joshjessup/Group49/README.md

# Group49
2019/20 UBC ECE Capstone - Group 49
