joshjessup/Group49/Bill of materials/Non-MFG BOM.xlsx

Part | Description | Cost | Link | Comment
Battery 1 | Li, 3.7V, 1200mAh, 62x34x5mm | 9.95USD | https://www.adafruit.com/product/258 | ~32 hr battery life according to our estimates - we have this battery
Battery 2 | Li, 3.7V, 400mAh, 35.5x16.6x7.6mm | 6.95USD | https://www.adafruit.com/product/3898 | 32*0.33 = 10 hr battery life - optimal for reduced enclosure size
Battery 3 | Li, 3.7V, 2000mAh, 60x36x7mm | 12.5USD | https://www.adafruit.com/product/2011 | 32 * 1.66 = 53 hr battery life
Electrodes | Dry and/or wet | N/A | N/A | Provided by SimPL
Enclosure | 3D Printed | N/A | N/A | Cost dependant on printing, designed for small battery (Battery 2)
PicKit 4 | for programming MCU | 75.80CAD | https://www.digikey.ca/en/products/detail/microchip-technology/PG164140/8536593
FTDI | for serial programming | 32.33CAD | https://www.digikey.ca/en/products/detail/ftdi-future-technology-devices-international-ltd/TTL-232RG-VIP-WE/2441358
MicroSD |  | Various |  | Any MicroSD
