joshjessup/Group49/Bill of materials/Bill of Materials-EEG_circuit.xlsx

Case/Package | Category | Description | Footprint | LibRef | Manufacturer 1 | Manufacturer Lifecycle 1 | Manufacturer Part Number 1 | Quantity | Supplier 1 | Supplier Currency 1 | Supplier Order Qty 1 | Supplier Part Number 1 | Supplier Stock 1 | Supplier Subtotal 1 | Supplier Subtotal per Board 1 | Supplier Unit Price 1 | Designator | Value
 |  | 0402 Cap 18pF | 0402resistor | 18pF_Cap | KEMET (https://octopart-clicks.com/click/altium?sku=399-19371-6-ND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) | Unknown | C0402C180K5RAC7867 (https://octopart-clicks.com/click/altium?sku=399-19371-6-ND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) | 2 | Digi-Key | USD | 2 | 399-19371-6-ND (https://octopart-clicks.com/click/altium?sku=399-19371-6-ND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) | 3539 | 0.42 | 0.42 | 0.21 | C20, C21 | 18pF
 |  | CONN HEADER SMD 2POS 2MM | Battery_Conn | B2B-PH-SM4-TBT(LF)(SN) | JST (https://octopart-clicks.com/click/altium?sku=455-2872-6-ND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) | Volume Production | B2B-PH-SM4-TBT(LF)(SN) (https://octopart-clicks.com/click/altium?sku=455-2872-6-ND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) | 1 | Digi-Key |  | 1 | 455-2872-6-ND (https://octopart-clicks.com/click/altium?sku=455-2872-6-ND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) | 0 |  |  |  | J1
 |  | GLOBAL CONNECTOR TECHNOLOGY MEM2067-02-180-00-A MEMORY CARD CONNECTOR, 8 POSITION | SD_Conn | MEM2067-02-180-00-A | Global Connector Technology (https://octopart-clicks.com/click/altium?manufacturer=Global%20Connector%20Technology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) | Volume Production | MEM2067-02-180-00-A (https://octopart-clicks.com/click/altium?manufacturer=Global%20Connector%20Technology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) | 1 | Digi-Key |  | 1 | 2073-MEM2067-02-180-00-ACT-ND (https://octopart-clicks.com/click/altium?manufacturer=Global%20Connector%20Technology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) | 0 |  |  |  | J3
 |  | MINI SPDT SLIDE SWITCH 6.7 X 2.7 MM PINS 4-9 ARE MOUNTING | SW_SPDT | 450404015514 | Wurth Electronics (https://octopart-clicks.com/click/altium?sku=732-13665-6-ND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) | Unknown | 450404015514 (https://octopart-clicks.com/click/altium?sku=732-13665-6-ND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) | 1 | Digi-Key | USD | 1 | 732-13665-6-ND (https://octopart-clicks.com/click/altium?sku=732-13665-6-ND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) | 2490 | 0.75 | 0.75 | 0.75 | SW3
 |  | WURTH ELEKTRONIK 61300621121 Board-To-Board Connector, Vertical, WR-PHD Series, Through Hole, Header, 6 Contacts, 2.54 mm | 6pin_Header | 61300621121 | Wurth Electronics (https://octopart-clicks.com/click/altium?sku=732-5295-ND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) | Volume Production | 61300621121 (https://octopart-clicks.com/click/altium?sku=732-5295-ND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) | 1 | Digi-Key | USD | 1 | 732-5295-ND (https://octopart-clicks.com/click/altium?sku=732-5295-ND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) | 2352 | 0.54 | 0.54 | 0.54 | J4
 |  | WURTH ELEKTRONIK 61301211121 Board-To-Board Connector, Vertical, WR-PHD Series, Through Hole, Header, 12 Contacts, 2.54 mm | HDR1X12 | 61301211121 | Wurth Electronics (https://octopart-clicks.com/click/altium?sku=732-5323-ND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) | Volume Production | 61301211121 (https://octopart-clicks.com/click/altium?sku=732-5323-ND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) | 1 | Digi-Key | USD | 1 | 732-5323-ND (https://octopart-clicks.com/click/altium?sku=732-5323-ND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) | 266 | 0.54 | 0.54 | 0.54 | J2
0402 |  | 0402 Cap 0.1uF | 0402resistor | 0.1uF_Cap | Samsung (https://octopart-clicks.com/click/altium?sku=1276-1022-6-ND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) | Volume Production | CL05A104KP5NNNC (https://octopart-clicks.com/click/altium?sku=1276-1022-6-ND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) | 6 | Digi-Key | USD | 6 | 1276-1022-6-ND (https://octopart-clicks.com/click/altium?sku=1276-1022-6-ND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) | 11994234 | 0.6 | 0.6 | 0.1 | C2, C5, C7, C10, C12, C18 | 0.1uF
0402 |  | 0402 Cap 1uF | 0402resistor | 1uF_Cap | Murata (https://octopart-clicks.com/click/altium?sku=490-14577-6-ND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) | Volume Production | GRM153R61A105ME95D (https://octopart-clicks.com/click/altium?sku=490-14577-6-ND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) | 5 | Digi-Key | USD | 5 | 490-14577-6-ND (https://octopart-clicks.com/click/altium?sku=490-14577-6-ND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) | 42932 | 0.95 | 0.95 | 0.19 | C1, C4, C6, C15, C16 | 1uF
0402 |  | 0402 Cap 1.5nF | 0402resistor | 1.5nF_Cap | Samsung (https://octopart-clicks.com/click/altium?sku=1276-1521-6-ND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) | Volume Production | CL05B152KB5NNNC (https://octopart-clicks.com/click/altium?sku=1276-1521-6-ND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) | 1 | Digi-Key | USD | 1 | 1276-1521-6-ND (https://octopart-clicks.com/click/altium?sku=1276-1521-6-ND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) | 647850 | 0.1 | 0.1 | 0.1 | C3 | 1.5nF
0402 |  | 0402 Cap 4.7uF | 0402resistor | 4.7uF_Cap | Murata (https://octopart-clicks.com/click/altium?sku=490-14306-6-ND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) | Volume Production | GRM155R61A475MEAAD (https://octopart-clicks.com/click/altium?sku=490-14306-6-ND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) | 3 | Digi-Key | USD | 3 | 490-14306-6-ND (https://octopart-clicks.com/click/altium?sku=490-14306-6-ND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) | 821187 | 0.75 | 0.75 | 0.25 | C8, C13, C14 | 4.7uF
0402 |  | 0402 Cap 10uF | 0402resistor | 10uF_Cap | Samsung (https://octopart-clicks.com/click/altium?sku=1276-1450-6-ND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) | Volume Production | CL05A106MP5NUNC (https://octopart-clicks.com/click/altium?sku=1276-1450-6-ND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) | 4 | Digi-Key | USD | 4 | 1276-1450-6-ND (https://octopart-clicks.com/click/altium?sku=1276-1450-6-ND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) | 3222186 | 1.84 | 1.84 | 0.46 | C9, C11, C17, C22 | 10uF
0402 |  | RES ARRAY 4 RES 1.6K OHM 0804 | Rarray | EXB-N8V162JX | Panasonic (https://octopart-clicks.com/click/altium?sku=Y10162DKR-ND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) | Volume Production | EXB-N8V162JX (https://octopart-clicks.com/click/altium?sku=Y10162DKR-ND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) | 3 | Digi-Key | USD | 3 | Y10162DKR-ND (https://octopart-clicks.com/click/altium?sku=Y10162DKR-ND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) | 21269 | 0.33 | 0.33 | 0.11 | U3, U6, U9
0402 |  | RES SMD 0 OHM JUMPER 1/16W 0402 | 0402resistor | 0_Res | Yageo (https://octopart-clicks.com/click/altium?sku=311-0.0JRDKR-ND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) | Volume Production | RC0402JR-070RL (https://octopart-clicks.com/click/altium?sku=311-0.0JRDKR-ND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) | 2 | Digi-Key | USD | 2 | 311-0.0JRDKR-ND (https://octopart-clicks.com/click/altium?sku=311-0.0JRDKR-ND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) | 49052469 | 0.2 | 0.2 | 0.1 | R2, R3 | 0R
0402 |  | RES SMD 1K OHM 1% 1/16W 0402 | 0402resistor | 1k_Res | Yageo (https://octopart-clicks.com/click/altium?sku=311-1.00KLRCT-ND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) | Volume Production | RC0402FR-071KL (https://octopart-clicks.com/click/altium?sku=311-1.00KLRCT-ND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) | 2 | Digi-Key | USD | 2 | 311-1.00KLRCT-ND (https://octopart-clicks.com/click/altium?sku=311-1.00KLRCT-ND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) | 38781443 | 0.2 | 0.2 | 0.1 | R13, R15 | 1k
0402 |  | RES SMD 1M OHM 1% 1/16W 0402 | 0402resistor | 1M_Res | Yageo (https://octopart-clicks.com/click/altium?sku=311-1.00MLRCT-ND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) | Volume Production | RC0402FR-071ML (https://octopart-clicks.com/click/altium?sku=311-1.00MLRCT-ND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) | 2 | Digi-Key | USD | 2 | 311-1.00MLRCT-ND (https://octopart-clicks.com/click/altium?sku=311-1.00MLRCT-ND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) | 9483260 | 0.2 | 0.2 | 0.1 | R1, R16 | 1M
0402 |  | RES SMD 1.6M OHM 5% 1/16W 0402 | 0402resistor | 1_6M_Res | Yageo (https://octopart-clicks.com/click/altium?sku=YAG3284DKR-ND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) | Volume Production | RC0402JR-071M6L (https://octopart-clicks.com/click/altium?sku=YAG3284DKR-ND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) | 1 | Digi-Key | USD | 1 | YAG3284DKR-ND (https://octopart-clicks.com/click/altium?sku=YAG3284DKR-ND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) | 10969 | 0.1 | 0.1 | 0.1 | R9 | 1.6M
0402 |  | RES SMD 10K OHM 1% 1/16W 0402 | 0402resistor | 10k_Res | Yageo (https://octopart-clicks.com/click/altium?sku=311-10.0KLRCT-ND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) | Volume Production | RC0402FR-0710KL (https://octopart-clicks.com/click/altium?sku=311-10.0KLRCT-ND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) | 1 | Digi-Key | USD | 1 | 311-10.0KLRCT-ND (https://octopart-clicks.com/click/altium?sku=311-10.0KLRCT-ND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) | 50506467 | 0.1 | 0.1 | 0.1 | R12 | 10k
0402 |  | RES SMD 100K OHM 1% 1/16W 0402 | 0402resistor | 100k_Res | Yageo (https://octopart-clicks.com/click/altium?sku=311-100KLRCT-ND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) | Volume Production | RC0402FR-07100KL (https://octopart-clicks.com/click/altium?sku=311-100KLRCT-ND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) | 5 | Digi-Key | USD | 5 | 311-100KLRCT-ND (https://octopart-clicks.com/click/altium?sku=311-100KLRCT-ND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) | 46409372 | 0.5 | 0.5 | 0.1 | R5, R6, R7, R8, R11 | 100k
0402 |  | RES SMD 180K OHM 5% 1/16W 0402 | 0402resistor | 180k_Res | Yageo (https://octopart-clicks.com/click/altium?sku=311-180KJRDKR-ND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) | Volume Production | RC0402JR-07180KL (https://octopart-clicks.com/click/altium?sku=311-180KJRDKR-ND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) | 1 | Digi-Key | USD | 1 | 311-180KJRDKR-ND (https://octopart-clicks.com/click/altium?sku=311-180KJRDKR-ND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) | 33790 | 0.1 | 0.1 | 0.1 | R10 | 180k
0402 |  | RES SMD 453K OHM 1% 1/16W 0402 | 0402resistor | 453k_Res | Yageo (https://octopart-clicks.com/click/altium?sku=YAG3164DKR-ND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) | Volume Production | RC0402FR-07453KL (https://octopart-clicks.com/click/altium?sku=YAG3164DKR-ND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) | 1 | Digi-Key | USD | 1 | YAG3164DKR-ND (https://octopart-clicks.com/click/altium?sku=YAG3164DKR-ND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) | 641723 | 0.1 | 0.1 | 0.1 | R4 | 453k
0402 |  | RES SMD 470K OHM 5% 1/16W 0402 | 0402resistor | 470k_Res | Yageo (https://octopart-clicks.com/click/altium?sku=311-470KJRDKR-ND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) | Volume Production | RC0402JR-07470KL (https://octopart-clicks.com/click/altium?sku=311-470KJRDKR-ND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) | 1 | Digi-Key | USD | 1 | 311-470KJRDKR-ND (https://octopart-clicks.com/click/altium?sku=311-470KJRDKR-ND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) | 1635867 | 0.1 | 0.1 | 0.1 | R14 | 470k
0603 |  | FIXED IND 2.2UH 500MA 250 MOHM | 0603INDUCTOR | 2_2uH_Inductor | TDK (https://octopart-clicks.com/click/altium?sku=445-6385-6-ND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) | Volume Production | MLZ1608A2R2WT000 (https://octopart-clicks.com/click/altium?sku=445-6385-6-ND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) | 1 | Digi-Key | USD | 1 | 445-6385-6-ND (https://octopart-clicks.com/click/altium?sku=445-6385-6-ND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) | 11492 | 0.17 | 0.17 | 0.17 | L1 | 2.2uH
0603 |  | Inductor | 0603INDUCTOR | 4_7uH_Inductor | TDK (https://octopart-clicks.com/click/altium?sku=445-6390-6-ND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) | Volume Production | MLZ1608M4R7WT000 (https://octopart-clicks.com/click/altium?sku=445-6390-6-ND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) | 1 | Digi-Key | USD | 1 | 445-6390-6-ND (https://octopart-clicks.com/click/altium?sku=445-6390-6-ND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) | 1507 | 0.17 | 0.17 | 0.17 | L2 | 4.7uH
0603 |  | LED BLUE CLEAR CHIP SMD | LED | LED1 | Vishay Lite-On (https://octopart-clicks.com/click/altium?sku=160-1827-1-ND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) | Volume Production | LTST-C193TBKT-5A (https://octopart-clicks.com/click/altium?sku=160-1827-1-ND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) | 1 | Digi-Key | USD | 1 | 160-1827-1-ND (https://octopart-clicks.com/click/altium?sku=160-1827-1-ND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) | 133364 | 0.45 | 0.45 | 0.45 | D2
0612 |  | YAGEO (PHYCOMP) CA0612KRX7R9BB102 Capacitor Array, C-Array, 1000 pF, 50 V, 10%, SMD, 4 Element | Cap_array | CA0612KRX7R9BB102 | Yageo (https://octopart-clicks.com/click/altium?sku=311-2073-6-ND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) | Volume Production | CA0612KRX7R9BB102 (https://octopart-clicks.com/click/altium?sku=311-2073-6-ND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) | 2 | Digi-Key | USD | 2 | 311-2073-6-ND (https://octopart-clicks.com/click/altium?sku=311-2073-6-ND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) | 7911 | 0.82 | 0.82 | 0.41 | U5, U7
1206 |  | 1206 Cap 100uF | 1206resistor | 100uF_Cap | Murata (https://octopart-clicks.com/click/altium?sku=490-4539-6-ND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) | Volume Production | GRM31CR60J107ME39L (https://octopart-clicks.com/click/altium?sku=490-4539-6-ND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) | 2 | Digi-Key | USD | 2 | 490-4539-6-ND (https://octopart-clicks.com/click/altium?sku=490-4539-6-ND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) | 1303159 | 2.16 | 2.16 | 1.08 | C19, C23 | 100uF
SMD/SMT |  | Crystal Oscillator | 3x5mm_XTAL | XTAL | ECS International (https://octopart-clicks.com/click/altium?manufacturer=ECS%20International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) | Volume Production | ECS-80-18-30-JGN-TR (https://octopart-clicks.com/click/altium?manufacturer=ECS%20International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) | 1 | Digi-Key | USD | 1 | XC2103DKR-ND (https://octopart-clicks.com/click/altium?manufacturer=ECS%20International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) | 2422 | 0.69 | 0.69 | 0.69 | Y1
SMD/SMT |  | SWITCH TACTILE SPST-NO 0.05A 16V | BasicTwoPinSwitch | PTS810SJK250SMTRLFS | ITT C&K (https://octopart-clicks.com/click/altium?sku=CKN10503DKR-ND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) | Volume Production | PTS810SJK250SMTRLFS (https://octopart-clicks.com/click/altium?sku=CKN10503DKR-ND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) | 2 | Digi-Key | USD | 2 | CKN10503DKR-ND (https://octopart-clicks.com/click/altium?sku=CKN10503DKR-ND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) | 69232 | 0.6 | 0.6 | 0.3 | SW1, SW2
SOT-23-5 |  | IC REG BUCK ADJ 1A SYNC SOT25 | SOT23_Buck | AP3417CKTR-G1 | Diodes (https://octopart-clicks.com/click/altium?sku=AP3417CKTR-G1DIDKR-ND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) | Volume Production | AP3417CKTR-G1 (https://octopart-clicks.com/click/altium?sku=AP3417CKTR-G1DIDKR-ND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) | 1 | Digi-Key | USD | 1 | AP3417CKTR-G1DIDKR-ND (https://octopart-clicks.com/click/altium?sku=AP3417CKTR-G1DIDKR-ND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) | 33002 | 0.41 | 0.41 | 0.41 | U2
SSOP |  | MICROCHIP - PIC32MX250F128B-I/SS - MCU, 32BIT, PIC32, 40MHZ, SSOP-28 | SSOP28 | PIC32MX250F128B-I/SS | Microchip (https://octopart-clicks.com/click/altium?manufacturer=Microchip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) | Volume Production | PIC32MX250F128B-I/SS (https://octopart-clicks.com/click/altium?manufacturer=Microchip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) | 1 | Digi-Key | USD | 1 | PIC32MX250F128B-I/SS-ND (https://octopart-clicks.com/click/altium?manufacturer=Microchip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) | 2605 | 3.57 | 3.57 | 3.57 | U8
TO-236-3 |  | TVS Diode Arrays 4.0 Volt 300 Watt Common Anode | SOT23-3_TVS | GSOT04C-G3-08 | Vishay Semiconductors (https://octopart-clicks.com/click/altium?manufacturer=Vishay%20Semiconductors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) | New Product | GSOT04C-G3-08 (https://octopart-clicks.com/click/altium?manufacturer=Vishay%20Semiconductors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) | 1 | Digi-Key | USD | 1 | GSOT04C-G3-08GIDKR-ND (https://octopart-clicks.com/click/altium?manufacturer=Vishay%20Semiconductors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) | 3725 | 0.43 | 0.43 | 0.43 | D1
TQFP | Data Acquisition - Analog Front End (AFE) | IC AFE 24BIT 16KSPS LN 64TQFP | 64-TQFP | ADS1299IPAGR | Texas Instruments (https://octopart-clicks.com/click/altium?sku=296-34818-6-ND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) | Volume Production | ADS1299IPAGR (https://octopart-clicks.com/click/altium?sku=296-34818-6-ND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) | 1 | Digi-Key | USD | 1 | 296-34818-6-ND (https://octopart-clicks.com/click/altium?sku=296-34818-6-ND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) | 1132 | 53.84 | 53.84 | 53.84 | U1
SOT-23-6 | PMIC - Voltage Regulators - DC DC Switching Regulators | IC REG BOOST ADJ 0.5A SYNC SOT6 | SOT23-6 | TPS61073DDCR | Texas Instruments (https://octopart-clicks.com/click/altium?sku=296-21898-2-ND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) | Volume Production | TPS61073DDCR (https://octopart-clicks.com/click/altium?sku=296-21898-2-ND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) | 1 | Digi-Key | USD | 1 | 296-21898-2-ND (https://octopart-clicks.com/click/altium?sku=296-21898-2-ND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) | 6000 |  |  |  | U4
