joshjessup/Group49/Enclosure/Full_Enclosure_Assembly.SLDASM

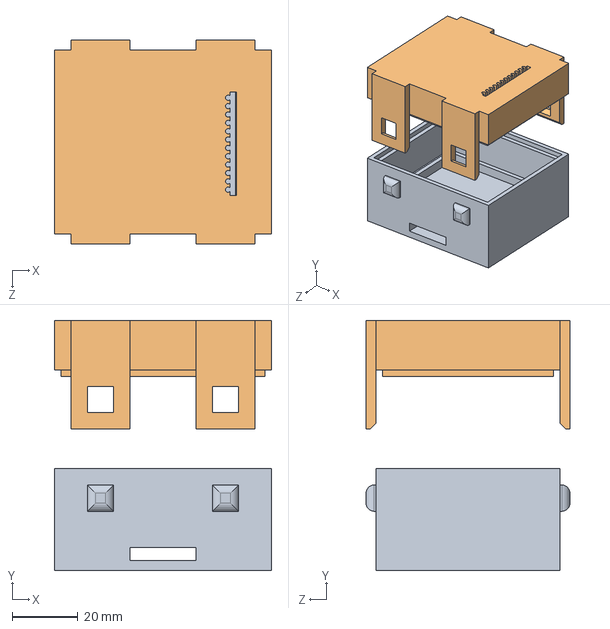
[picture p1: CAD file, 2020-03-23]
Enclosure/Full_Enclosure_Assembly.SLDASM
66.0 x 76.0 x 62.0 mm
Bottom_1
Top_1
