joshjessup/Group49/_schematics/3Dmodels/64-TQFP/PAG64.step

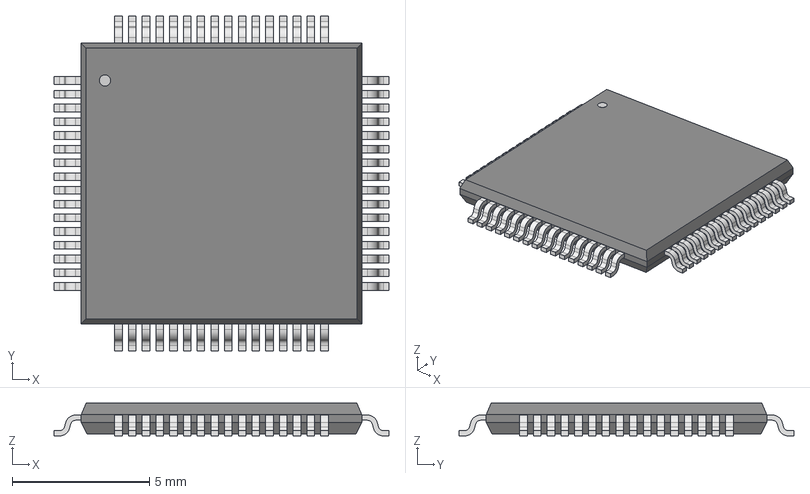
[picture p2: CAD file, 2020-01-19]
_schematics/3Dmodels/64-TQFP/PAG64.step
12.2 x 12.2 x 1.20 mm
