joshjessup/Group49/_schematics/3Dmodels/SOT23-6/SOT-23-6.step

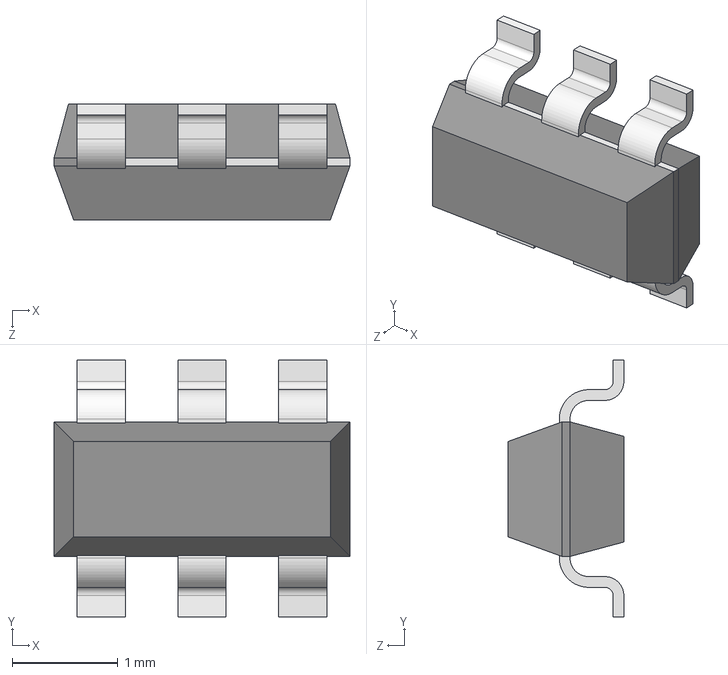
[picture p3: CAD file, 2020-01-19]
_schematics/3Dmodels/SOT23-6/SOT-23-6.step
2.79 x 2.43 x 1.09 mm
