joshjessup/Group49/_schematics/3Dmodels/SSOP28/SSOP28_MC-L.step

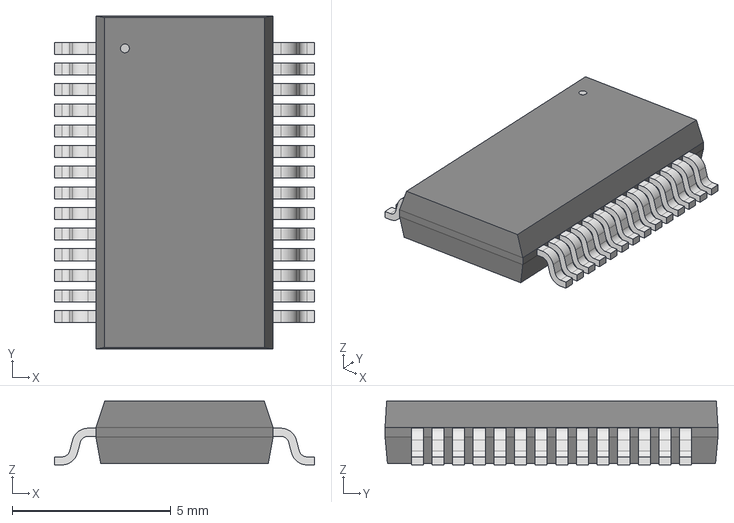
[picture p4: CAD file, 2019-11-26]
_schematics/3Dmodels/SSOP28/SSOP28_MC-L.step
8.20 x 10.5 x 2.01 mm
