joshjessup/Group49/_schematics/Project Outputs for EEG_circuit/ExportSTEP/EEG_PCB.step

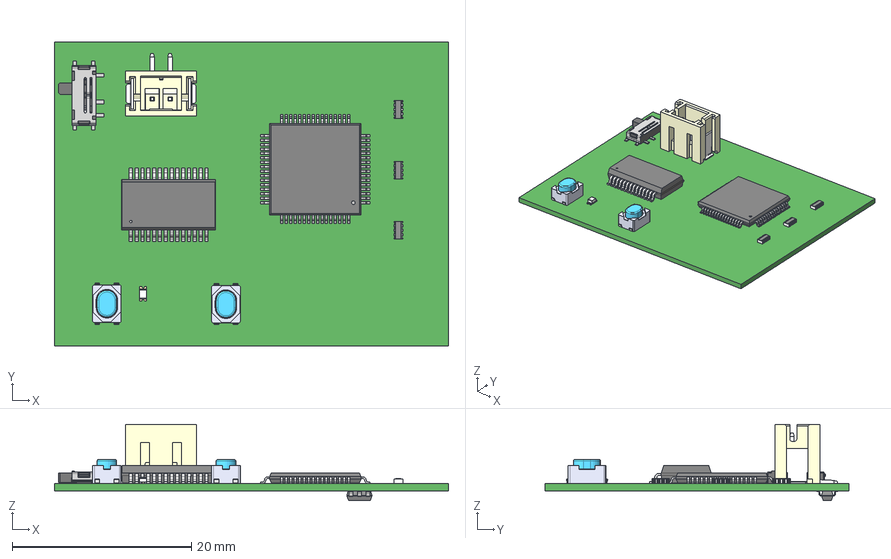
[picture p5: CAD file, 2020-02-17]
_schematics/Project Outputs for EEG_circuit/ExportSTEP/EEG_PCB.step
44.0 x 34.0 x 8.50 mm
Board
SOT-23-6
EXB-N8V162JX--3DModel-STEP-56544 x 3
PAG64
SSOP28_MC
PTS810_SJK_250_SMTR_LFS--3DModel-STEP-1 x 2
Frame
Pin_4
Frame_1
Pin_1
Pin_2
Pin_3
Slider_1
Slider
Cover
J3
B2B-PH-SM4-TB(LF)(SN)--3DModel-STEP-56544
LTST-C191TBKT-5A--3DModel-STEP-56544
