joshjessup/Group49/Enclosure/Bottom_1.SLDPRT

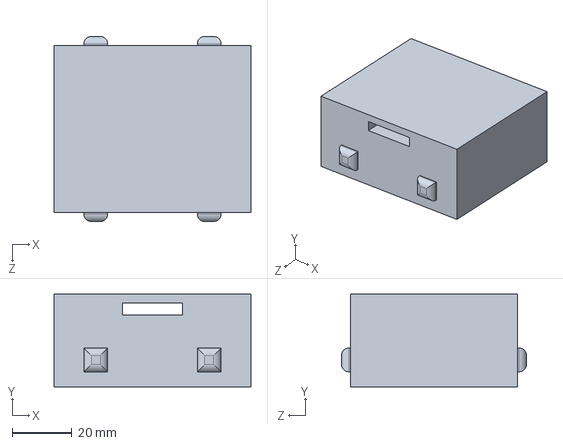
[picture p6: CAD file, 2020-03-23]
Enclosure/Bottom_1.SLDPRT
66.0 x 31.0 x 62.0 mm
