joshjessup/Group49/Enclosure/Top_1.SLDPRT

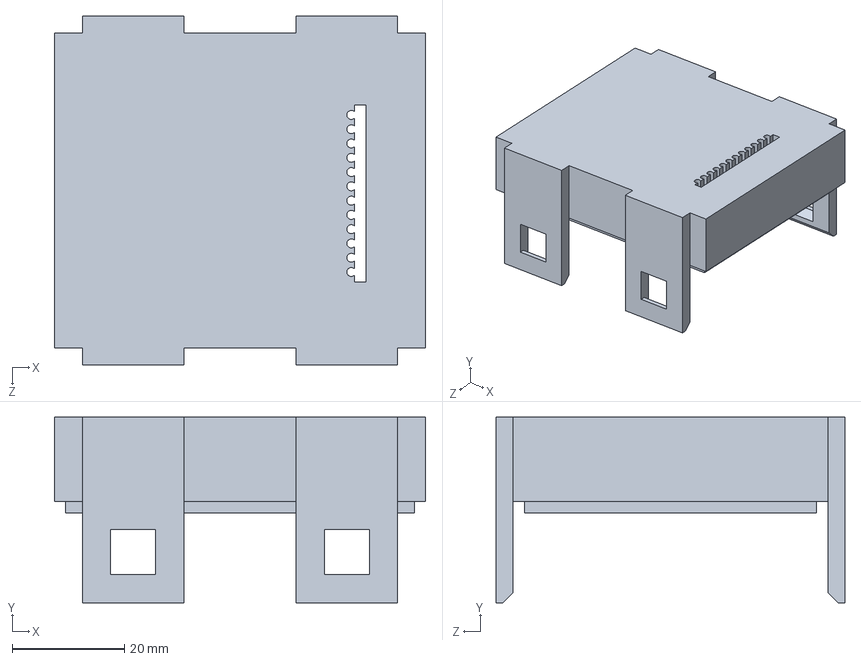
[picture p7: CAD file, 2020-03-23]
Enclosure/Top_1.SLDPRT
66.0 x 33.0 x 62.0 mm
