joshjessup/Group49/(list of files, cad)

Other CAD files:
_schematics/3Dmodels/64-TQFP/PAG64-L.step
_schematics/3Dmodels/SSOP28/SSOP28_MC.step
_schematics/3Dmodels/64-TQFP/PAG64-M.step
_schematics/3Dmodels/SSOP28/SSOP28_MC-M.step
Enclosure/Bottom_1.STL
Enclosure/Top_1.STL
