joshjessup/Group49/Enclosure/Enclosure_measurements.pdf

# ivi

t

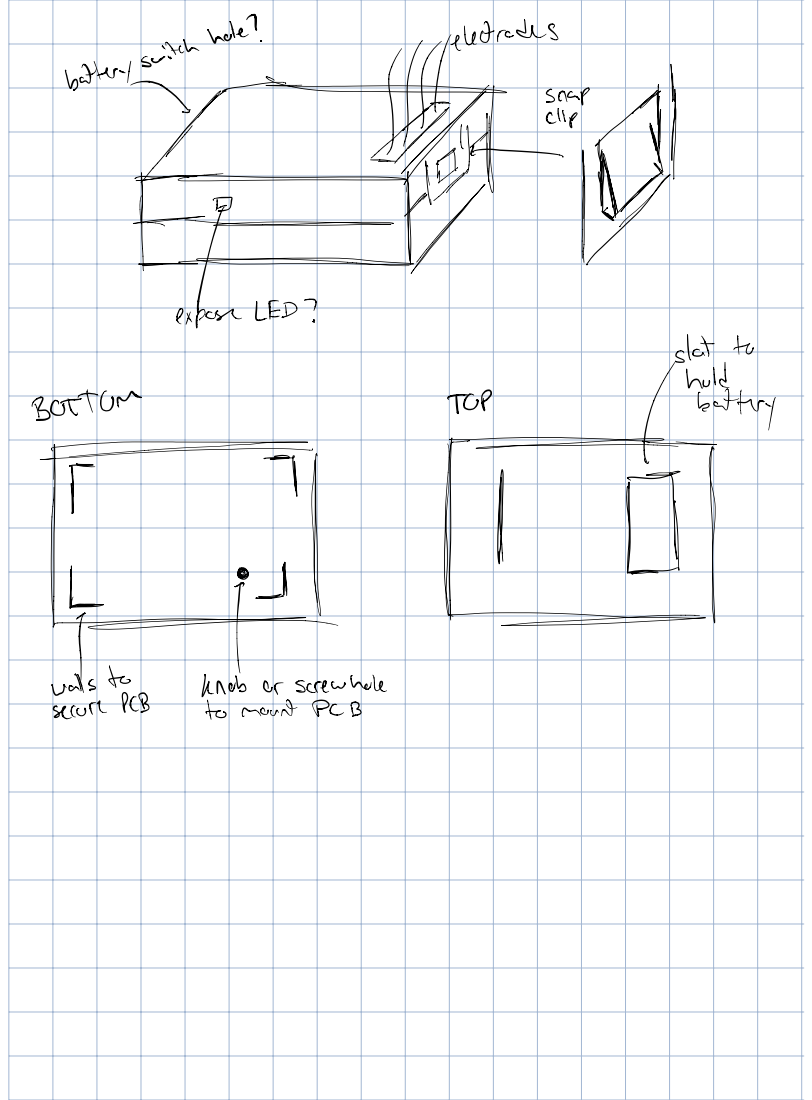
[picture p8: page 1]
iii

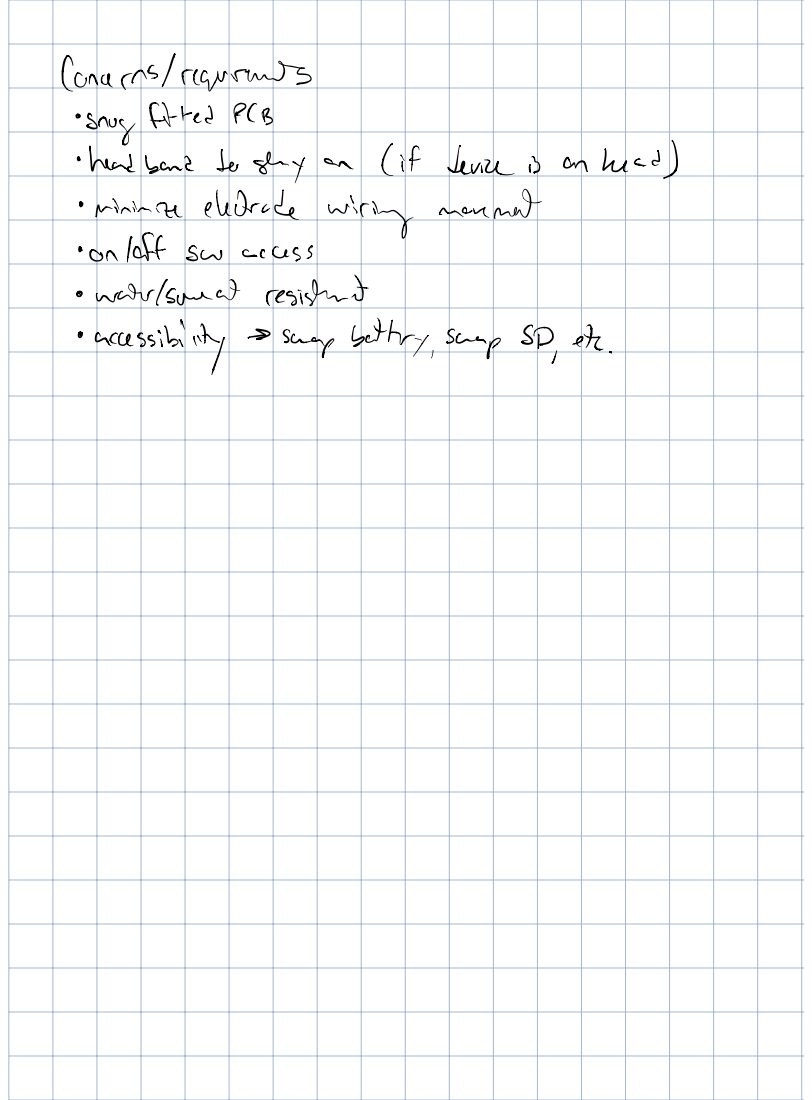
[picture p9: page 2]

Concerns regrows
snugfitted PCB
head bae te shy | | | | | on | if Lena is on head
minimize electrode | wiring manned
on off | | Sw | access
workout | | resident
accessibility | | | | swap battery sup SP etc

PCBIE.tn | | | fJt8jiH
| in | a

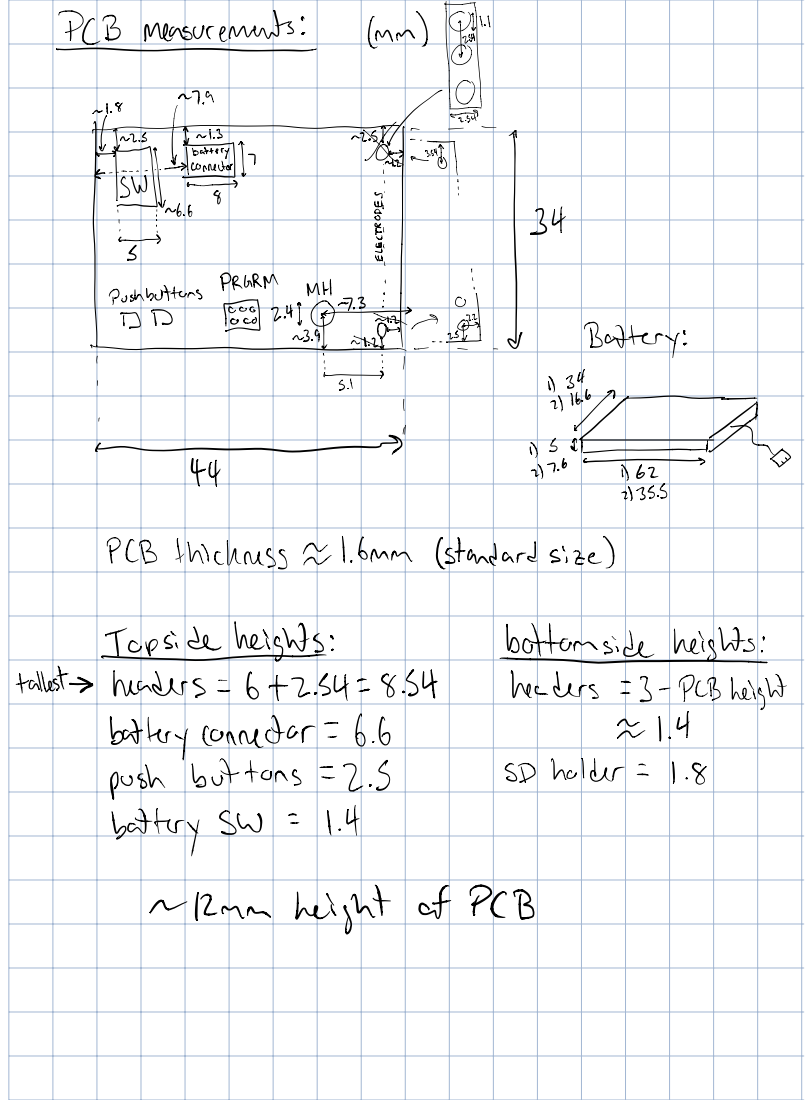
[picture p10: page 3]

PRURM | | i

pighfftons | | 2.4 | | | Battery

PCB thickness21.6mm standard size
Topside heights bottonsideheightsitathests ²

6 | 2.54 | | 8.54 | headers | | 3 | PCBheight

battery connector 6.6 | | | | | | | 21.4
push | buttons | | | 2.5 | | SD holder | | | 1.8
battery Sw | | | 1.4
Rum | height | | of PCB

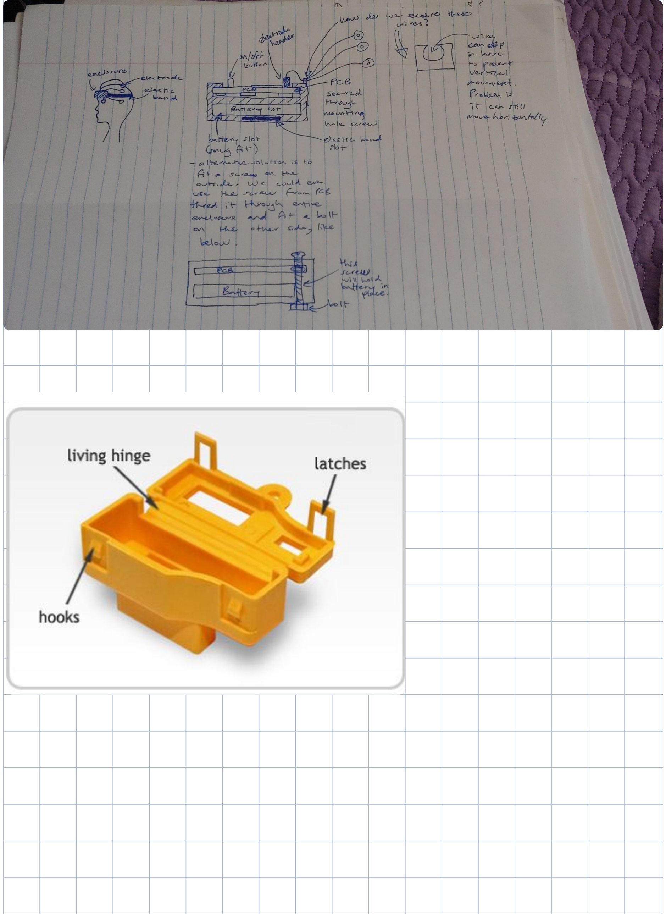
[picture p11: page 4]

## Tap piece flat on table in

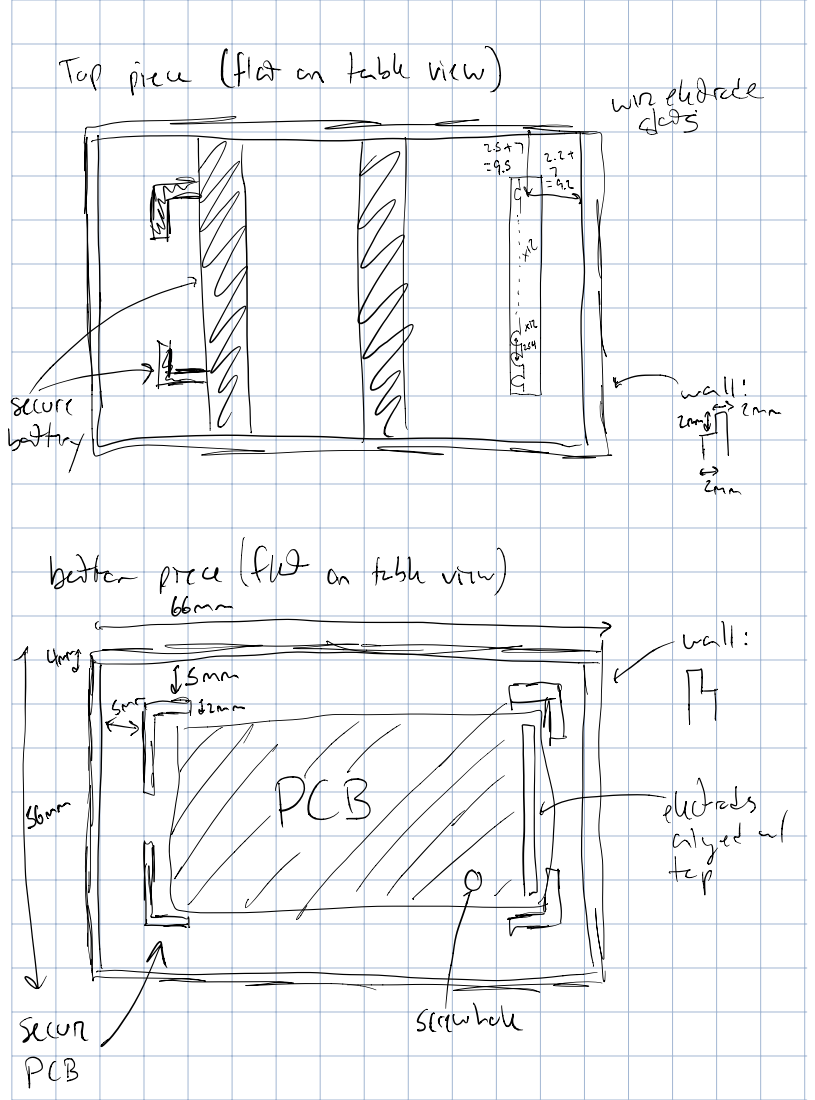
[picture p12: page 5]

iIH | | iq

ftp | i

bettor piece | | fled on | tbh view

| | battu | | piece | | side | | view
| | | | | | | | | ii | Epee

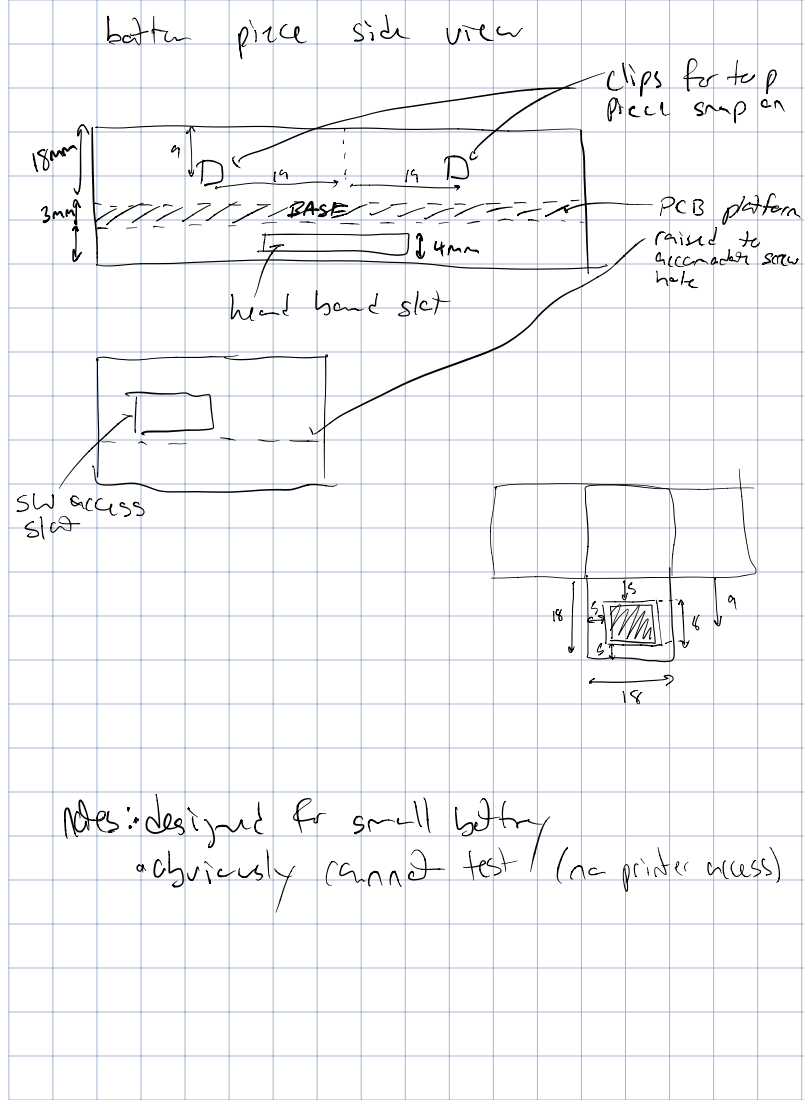
[picture p13: page 6]
GEffadorscrew; ssY; rates; designed; fr small belfry; obviously; cannot test; na printer access

is | | | In | | | | e
if | | | | | | | | | | p

1 band sky

I | | Irl
