joshjessup/Group49/_schematics/PDF_outputs/EEG_circuit.pdf

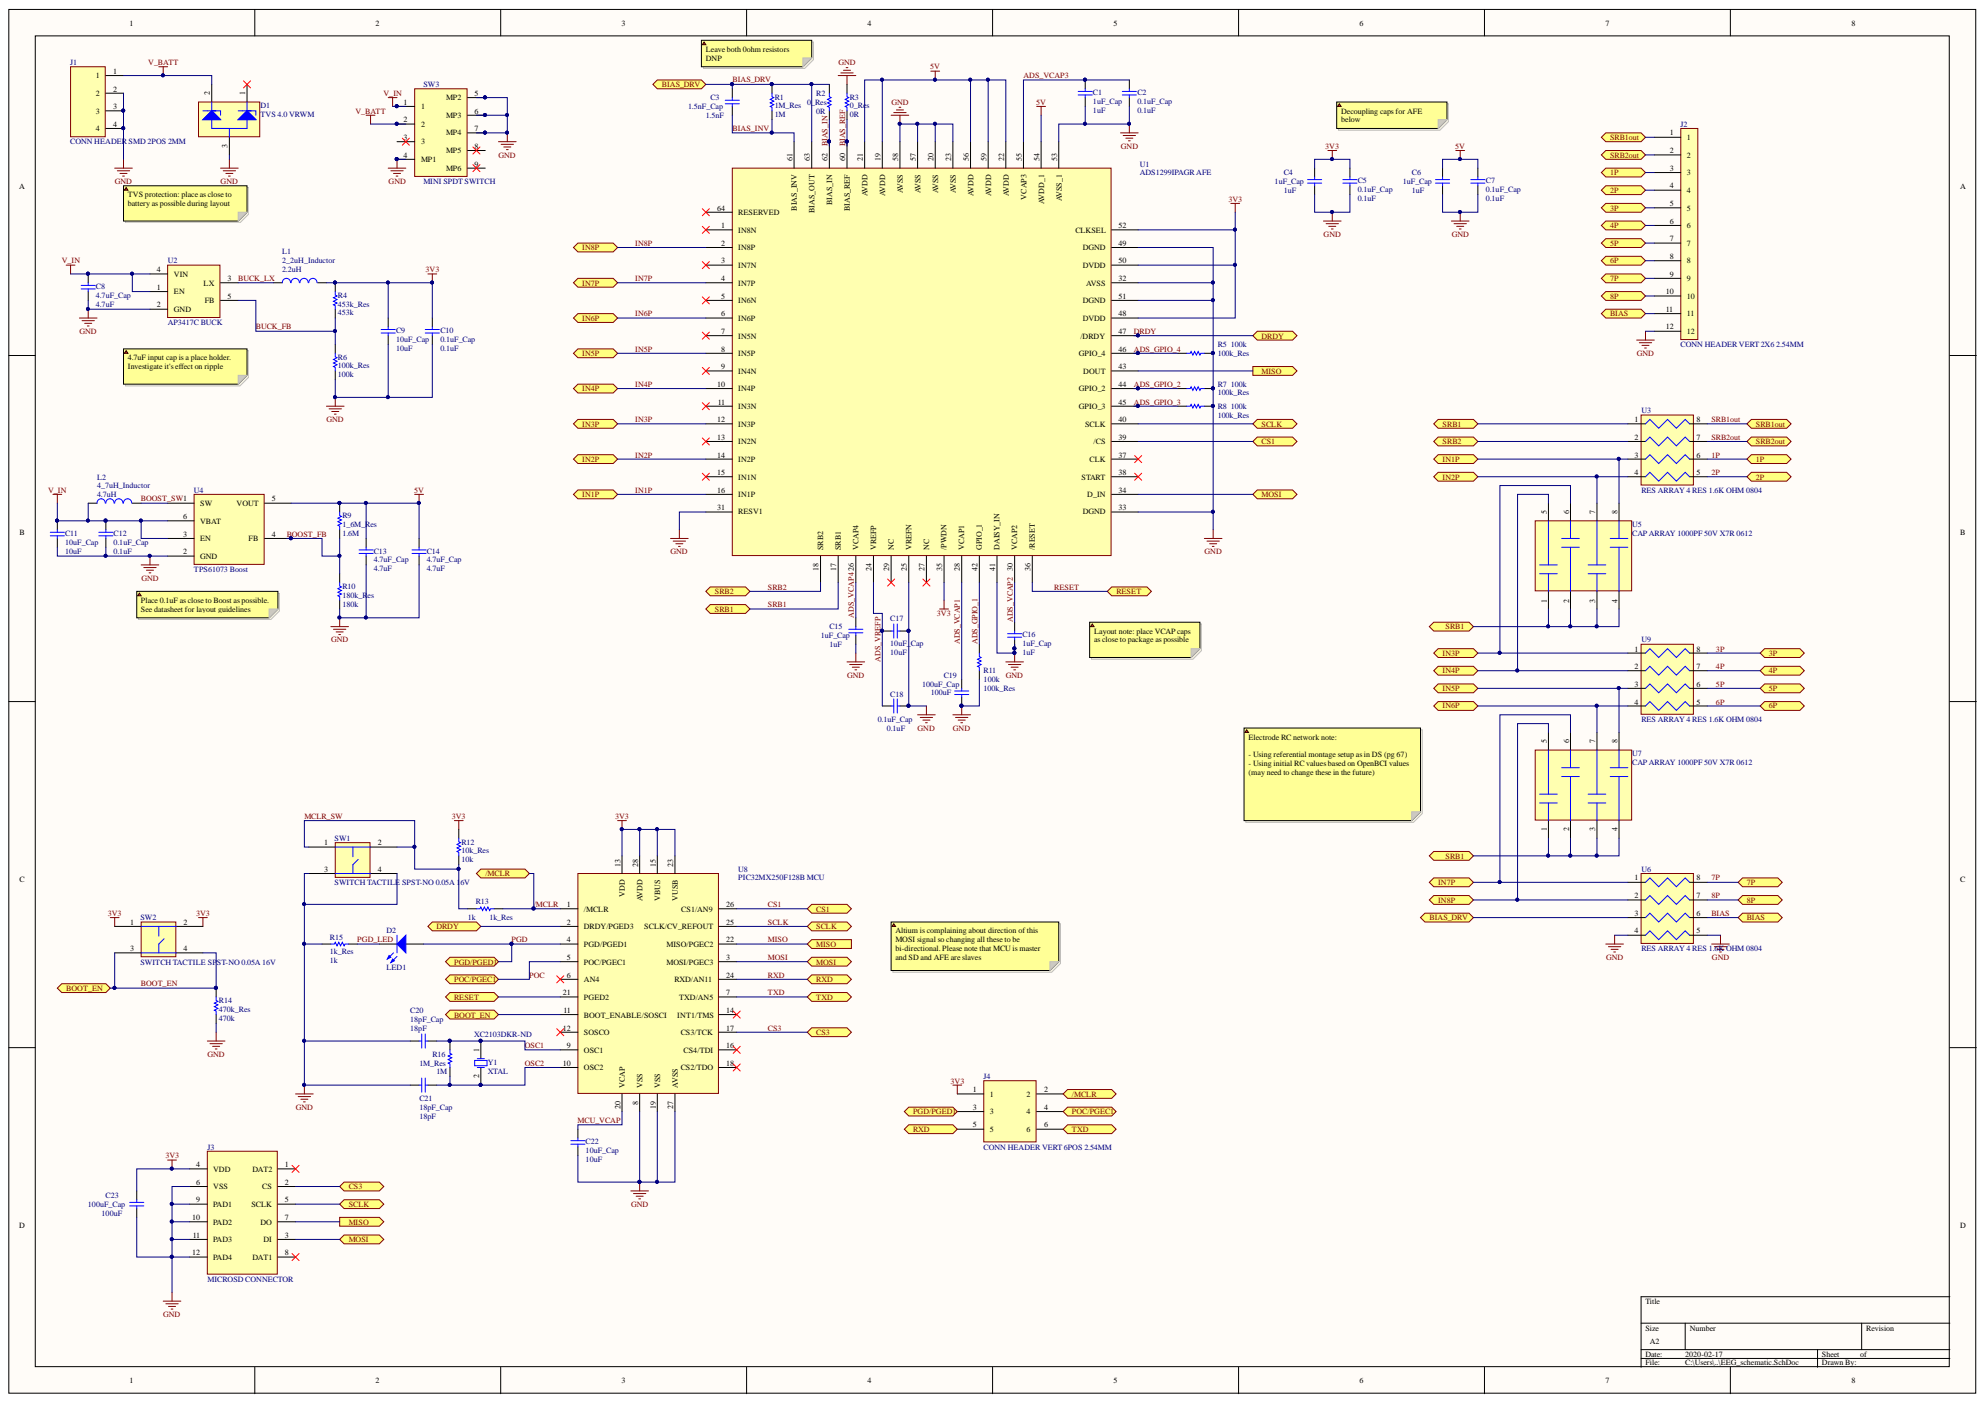
[picture p14: page 1]

Decoupling caps for AFE
below

GND
TVS protection: place as close to
battery as possible during layout

4.7uF input cap is a place holder.
Investigate it's effect on ripple

RES ARRAY 4 RES 1.6K OHM 0804

Place 0.1uF as close to Boost as possible.
See datasheet for layout guidelines

Layout note: place VCAP caps
as close to package as possible

Electrode RC network note:

- Using referential montage setup asin DS (pg 67)
- Using initial RC values based on OpenBCI values
(may need to change these in the future)

SWITCH TACTILE SPST-NO 0.05A 16V

Altium is complaining about direction of this
MOSI signal so changing all these to be
bi-directional. Please note that MCU is master
and SD and AFE are slaves

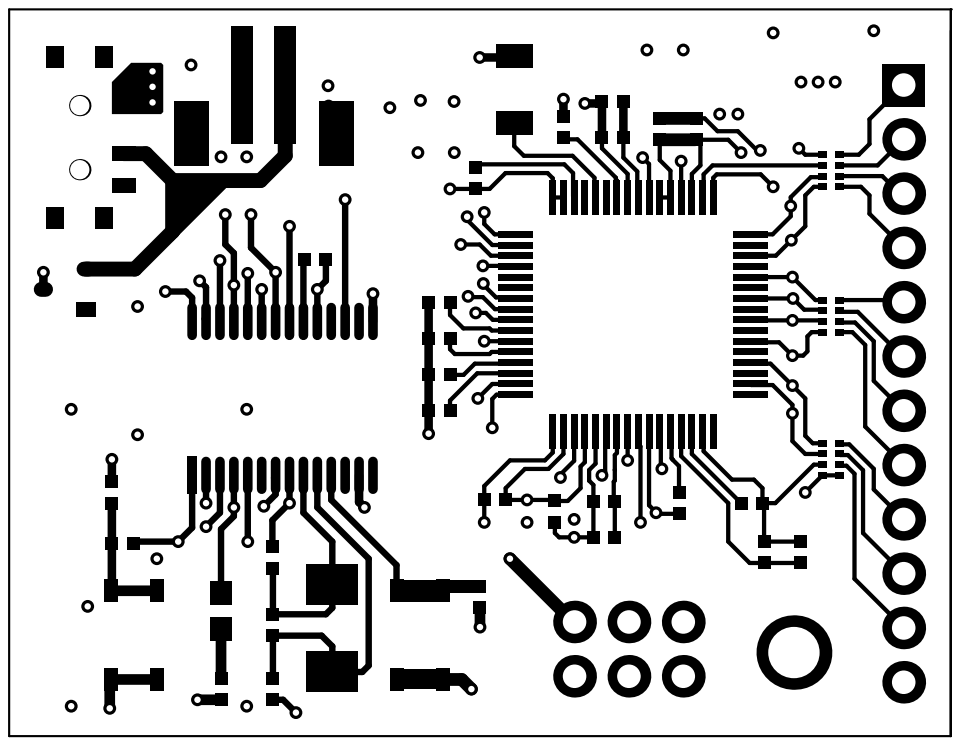
[picture p15: page 3]

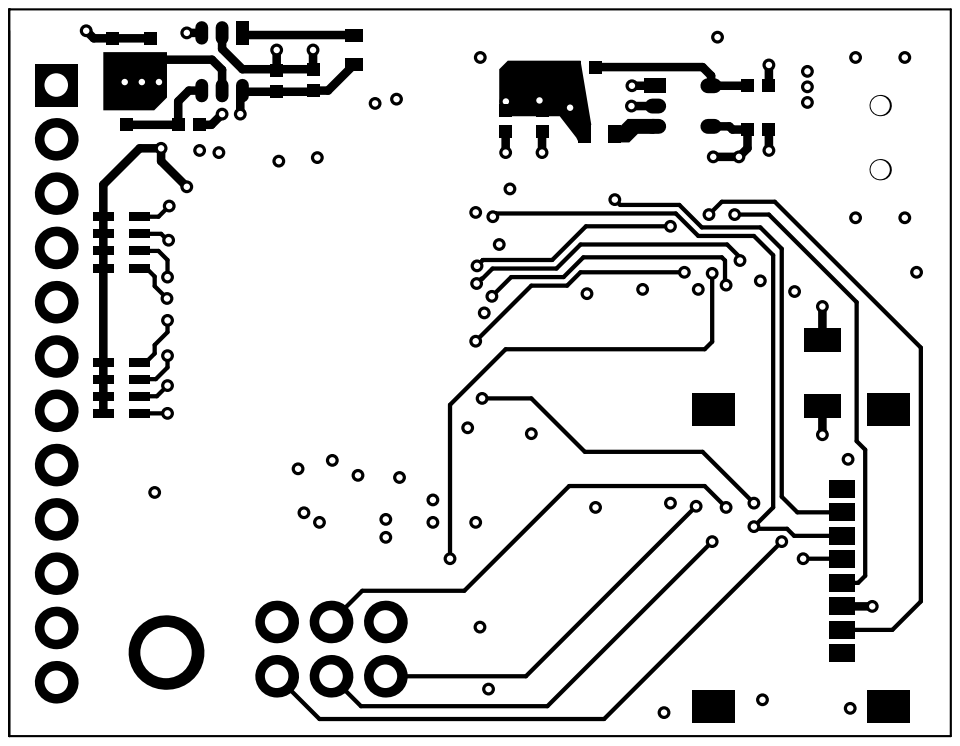
[picture p16: page 4]

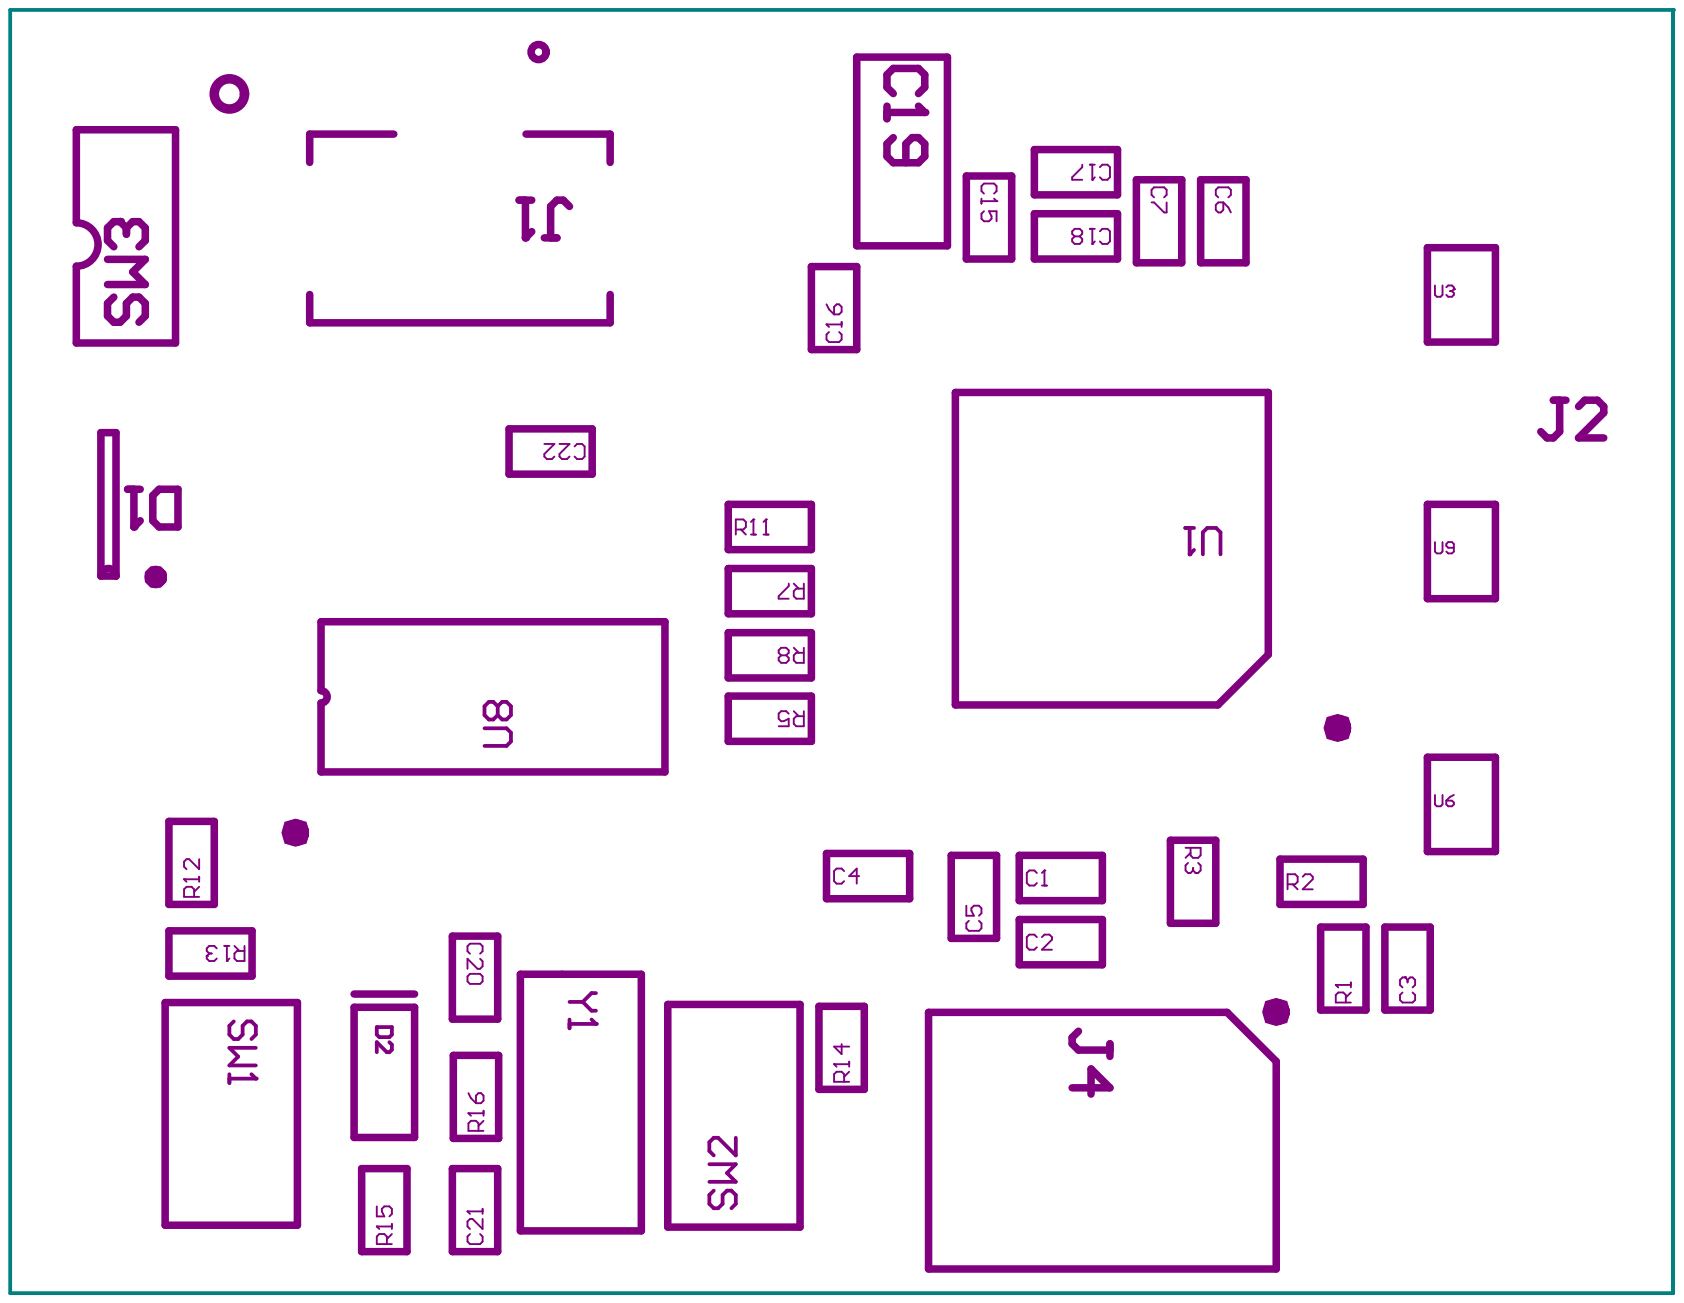
[picture p17: page 5]

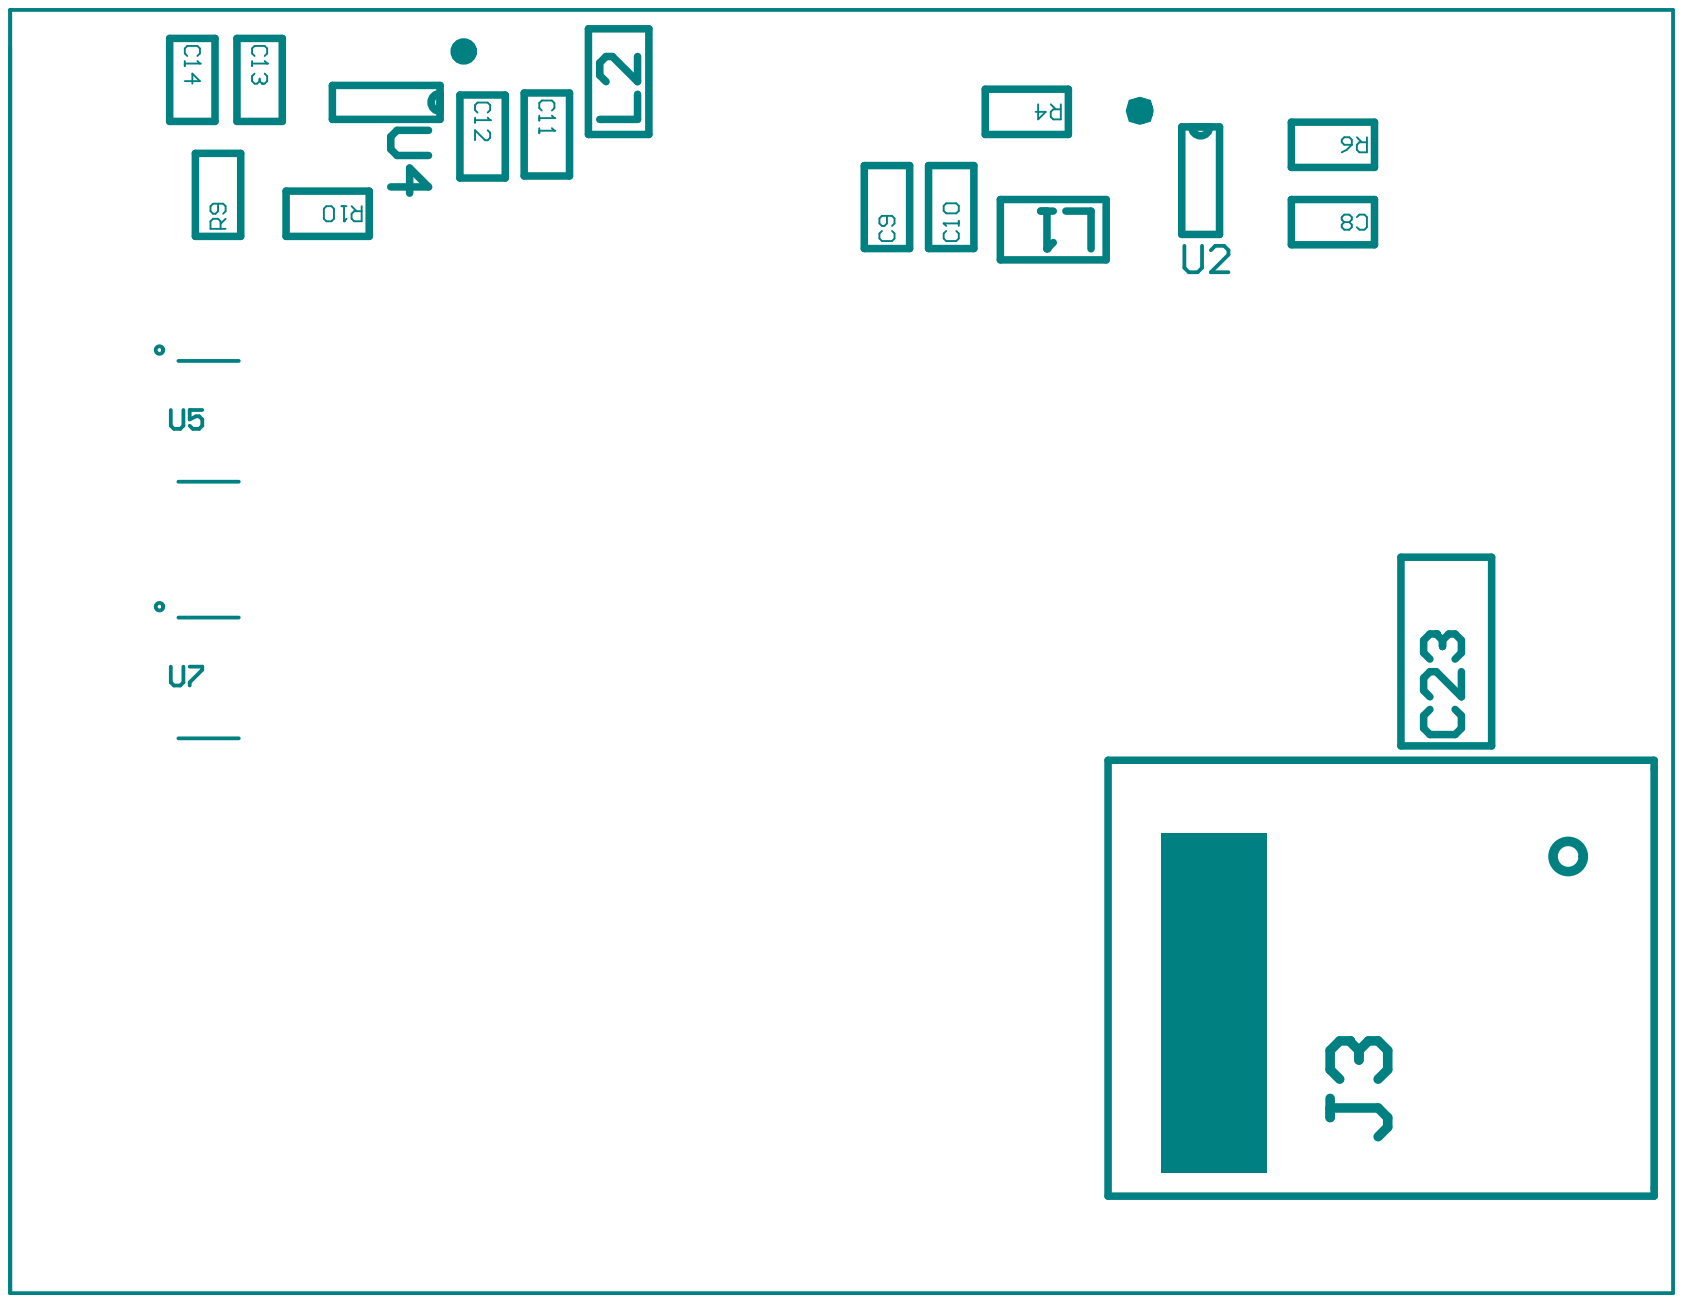
[picture p18: page 6]
