joshjessup/Group49/(list of files, drawings)

Other design files:
_schematics/daniel_schlib.schlib
_schematics/EEG_circuit.PrjPcb
_schematics/EEG_PCB.PcbDoc
_schematics/EEG_schematic.SchDoc
_schematics/PcbLibArash.PcbLib
_schematics/PcbLibBrian.PcbLib
_schematics/PcbLibDaniel.PcbLib
_schematics/PcbLibEEG.PcbLib
_schematics/PcbLibJosh.PcbLib
_schematics/SchlibEEG.SchLib
_schematics/Sheet1.SchDoc
