joshjessup/Group49/(commit log)

2019-11-21 Altium design files November 21st 2019
    [EEG_circuit.PrjPcb, EEG_schematic.SchDoc, PcbLibEEG.PcbLib, SchlibEEG.SchLib, Sheet1.SchDoc, daniel_schlib.schlib]
2019-11-21 add to folder
    [EEG_circuit.PrjPcb]
2019-11-21 push files to _schmatics folder
    [EEG_schematic.SchDoc, PcbLibEEG.PcbLib, SchlibEEG.SchLib, Sheet1.SchDoc, daniel_schlib.schlib]
2019-11-24 Schematic updates after review
    [EEG_schematic.SchDoc, SchlibEEG.SchLib]
2019-11-26 changed gnd on electrode outputs to srb1
    [EEG_circuit.PrjPcb, EEG_schematic.SchDoc]
2019-11-26 Added a footprint and edit schematic slightly
    [EEG_schematic.SchDoc, PcbLibEEG.PcbLib, SSOP28_MC-L.step, SSOP28_MC-M.step, SSOP28_MC.step]
2019-11-27 Changed bias circuitry
    [EEG_schematic.SchDoc]
2019-11-27 Edited Electrode Header
    [EEG_schematic.SchDoc, SchlibEEG.SchLib]
2019-11-28 working arduino fw for ms2. print out 3 byte int data from channel 0.
2020-01-14 adding footprints
    [EEG_schematic.SchDoc, PAG64-L.step, PAG64-M.step, PAG64.step, PcbLibEEG.PcbLib]
2020-01-14 Updated boost component values on schematic
    [EEG_schematic.SchDoc, PcbLibDaniel.PcbLib]
2020-01-14 Added many footprints
    [EEG_schematic.SchDoc, PcbLibEEG.PcbLib]
2020-01-15 added boost and 0603 footprint
    [EEG_circuit.PrjPcb, EEG_schematic.SchDoc, PcbLibDaniel.PcbLib, SOT-23-6.step]
2020-01-15 buck inductor 22uH -> 2.2uH
    [EEG_schematic.SchDoc]
2020-01-16 Added more footprints
    [PcbLibDaniel.PcbLib]
2020-01-17 added TVS diode, changed resistor array to 1.6k
    [EEG_schematic.SchDoc, SchlibEEG.SchLib]
2020-01-17 Updated footprints (0603 inductor, SOT23-6 boost)
    [PcbLibDaniel.PcbLib]
2020-01-17 added some footprints and added ref des to all the footprints in PcbLibEEG
    [PcbLibEEG.PcbLib]
2020-01-17 updated .gitignore
    [PcbLibEEG.PcbLib]
2020-01-18 added TVS footprint
    [PcbLibDaniel.PcbLib]
2020-01-19 changed .gitignore
    [PcbLibDaniel.PcbLib]
2020-01-19 made all design changes suggested by Daniel
    [PcbLibEEG.PcbLib]
2020-01-20 added PcbLibJosh and Brian to project
    [EEG_circuit.PrjPcb]
2020-01-20 added footprint for SD connector and made changes to battery on/off switch
    [EEG_circuit.PrjPcb, PcbLibBrian.PcbLib]
2020-01-20 added PCB libraries to project
    [EEG_circuit.PrjPcb]
2020-01-20 minor changes to pcblibbrian
2020-01-21 fixed footprint based on comments on footprint tracker
    [PcbLibBrian.PcbLib]
2020-01-21 added battery connector footprint and 3D model to PcbLibBrian.
    [PcbLibBrian.PcbLib]
2020-01-21 adjusted outline on TVS and 0603 footprint
    [PcbLibDaniel.PcbLib]
2020-01-21 Fixed all schematic compilation errors. Still in the process of adding all footprints and links to parts on schematic
    [EEG_PCB.PcbDoc, EEG_circuit.PrjPcb, EEG_schematic.SchDoc]
2020-01-21 Added sch symbol for SPDT SW
    [SchlibEEG.SchLib]
2020-01-21 cracking away at the schematic. Still not complete linking everything
    [EEG_circuit.PrjPcb, EEG_schematic.SchDoc, SchlibEEG.SchLib]
2020-01-21 added SPDT SW schematic symbol
    [daniel_schlib.schlib]
2020-01-22 chugging along on the schematic. Not complete yet
    [EEG_schematic.SchDoc]
2020-01-23 added footprint for capacitor array and modified battery connector
    [PcbLibBrian.PcbLib]
2020-01-23 Resistor Array
    [PcbLibArash.PcbLib]
2020-01-23 added footprint for LED and fixed capacitor array footprint
    [PcbLibBrian.PcbLib]
2020-01-23 added 3D model for LED
    [PcbLibBrian.PcbLib]
2020-01-24 3D model update
    [PcbLibArash.PcbLib]
2020-01-24 basically done schematic. Just need to link resistor footprint when that is completed
    [EEG_schematic.SchDoc, PcbLibEEG.PcbLib, SchlibEEG.SchLib]
2020-01-24 ensured that it compiles correctly. Still have not linked resistor array yet because my altium is being glitchy
    [EEG_schematic.SchDoc, PcbLibArash.PcbLib]
2020-01-25 linked resistor array sch symbol with its footprint
    [EEG_schematic.SchDoc, SchlibEEG.SchLib]
2020-01-28 Modified resistor array footprint/sch, battery sw sch, overall schematic, and started layout
    [EEG_PCB.PcbDoc, EEG_circuit.PrjPcb, EEG_schematic.SchDoc, PcbLibArash.PcbLib, SchlibEEG.SchLib, daniel_schlib.schlib]
2020-01-28 revised electrode filter pin assignments for cleaner layout
    [EEG_PCB.PcbDoc, EEG_schematic.SchDoc]
2020-01-29 Removed top overlay refdes from all footprints (used to create duplicates)
    [EEG_PCB.PcbDoc, PcbLibArash.PcbLib, PcbLibBrian.PcbLib, PcbLibDaniel.PcbLib, PcbLibEEG.PcbLib, PcbLibJosh.PcbLib]
2020-01-29 added 1x12 header sch and footprint
    [EEG_PCB.PcbDoc, PcbLibDaniel.PcbLib, SchlibEEG.SchLib, daniel_schlib.schlib]
2020-02-03 initial PCB layout
    [EEG_PCB.PcbDoc, EEG_schematic.SchDoc]
2020-02-04 added new fw code with SD card capabilities
    [SDconverted-2020-02-03_15-40-25.csv, SDconverted-2020-02-03_16-06-36.csv]
2020-02-04 made some small changes to Daniels PCB
    [EEG_PCB.PcbDoc]
2020-02-04 Edited top and bottom overlay
    [EEG_PCB.PcbDoc]
2020-02-05 minor updates
    [EEG_PCB.PcbDoc, EEG_circuit.PrjPcb]
2020-02-06 got rid of all DRC errors on PCB doc
    [EEG_PCB.PcbDoc]
2020-02-07 All DRCs gone for real this time
    [EEG_PCB.PcbDoc, PcbLibArash.PcbLib, PcbLibEEG.PcbLib]
2020-02-10 fixed assembly layer issues
    [EEG_PCB.PcbDoc, PcbLibBrian.PcbLib]
2020-02-11 completed output job
    [Bill of Materials-EEG_circuit.xlsx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]
2020-02-11 updated bottom assembly layer and output files
    [Bill of Materials-EEG_circuit.xlsx, EEG_PCB.PcbDoc, EEG_PCB.step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]
2020-02-13 added plated through hole
    [EEG_PCB.PcbDoc]
2020-02-13 fixed bottom silkscreen, generated gerbers
    [Bill of Materials-EEG_circuit.xlsx, EEG_PCB.PcbDoc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]
2020-02-13 updated BOM format
    [Bill of Materials-EEG_circuit.xlsx, EEG_PCB.step]
2020-02-13 for you dan
    [SchlibEEG.SchLib, daniel_schlib.schlib]
2020-02-14 Created cap sch symbols
    [daniel_schlib.schlib]
2020-02-14 added schlib stuff for res and ind
    [SchlibEEG.SchLib]
2020-02-17 Schematic now has all of its respective component designators
    [EEG_schematic.SchDoc, SchlibEEG.SchLib]
2020-02-17 Updated output files
    [Bill of Materials-EEG_circuit.xlsx, EEG_PCB.PcbDoc, EEG_PCB.step, EEG_circuit.PrjPcb, EEG_schematic.SchDoc, daniel_schlib.schlib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]
2020-02-22 added output file zip
    [Bill of Materials-EEG_circuit.xlsx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]
2020-03-17 Added Enclosure working folder, added non-PCB BOM
    [Bill of Materials-EEG_circuit.xlsx, Non-MFG BOM.xlsx]
2020-03-23 Enclosure solidworks and 3D print files
    [Bottom_1.SLDPRT, Bottom_1.STL, Full_Enclosure_Assembly.SLDASM, Non-MFG BOM.xlsx, Top_1.SLDPRT, Top_1.STL]
2020-04-09 updated non-mfg BOM
    [Non-MFG BOM.xlsx]
